Corey0531/Special_Reports_2024/機電資料/IRF520-MOSFET-Switch-module-circuito.jpg

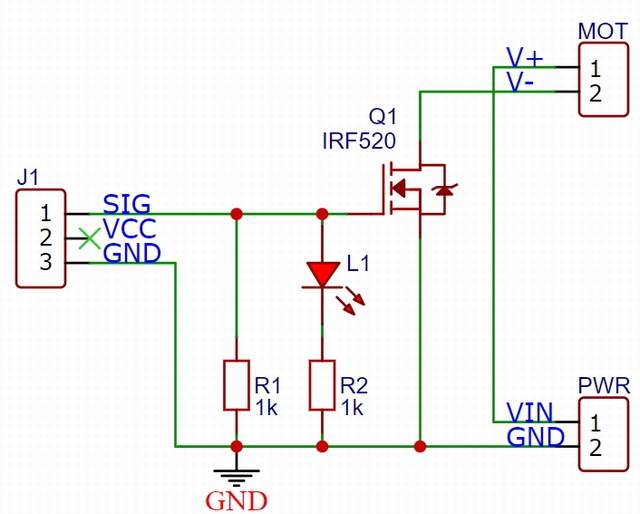
機電資料/IRF520-MOSFET-Switch-module-circuito.jpg
