Corey0531/Special_Reports_2024/機電資料/main_system.png

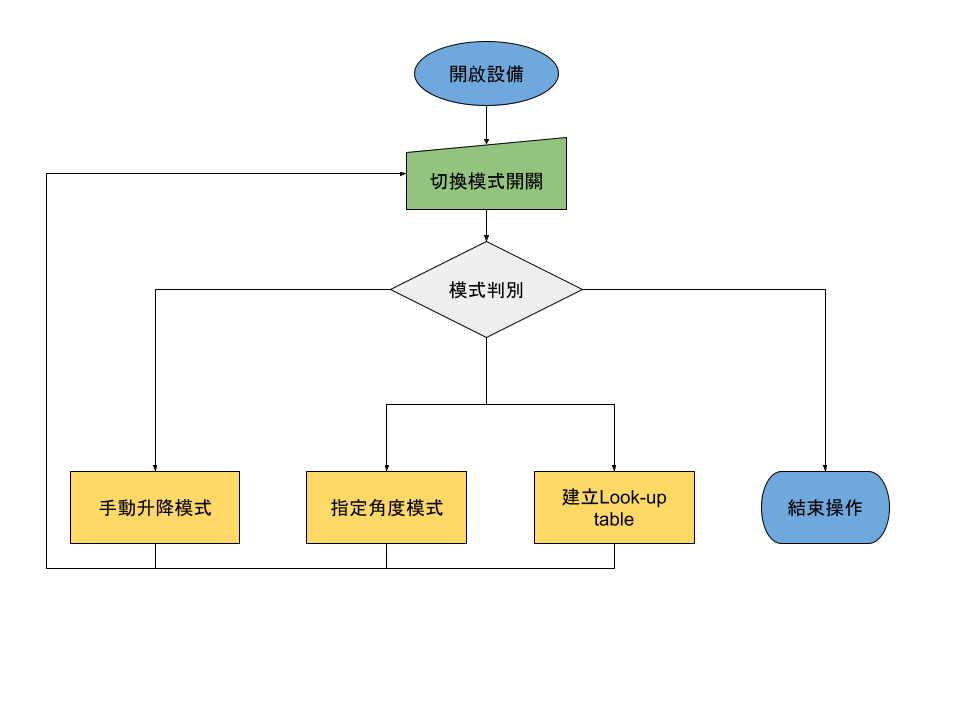
機電資料/main_system.png
