Corey0531/Special_Reports_2024/機電資料/mosfet_arduino.png

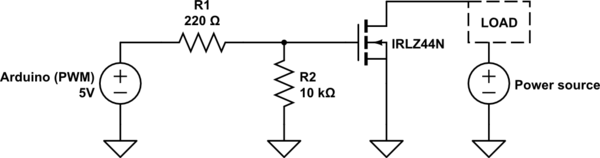
機電資料/mosfet_arduino.png
