Corey0531/Special_Reports_2024/機電資料/學長的電路圖.png

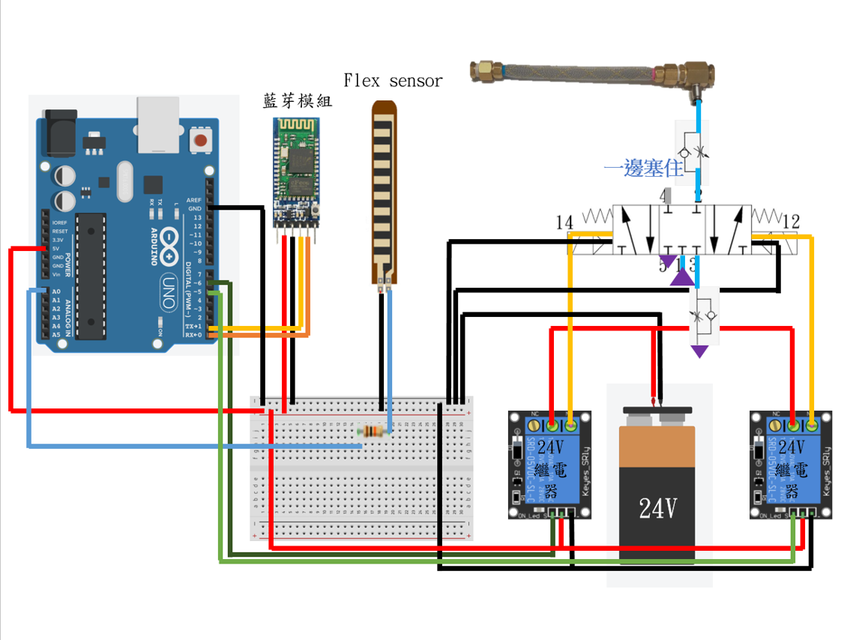
機電資料/學長的電路圖.png
