Corey0531/Special_Reports_2024/外殼creo檔案/編碼器/encoder_main_v4.stl

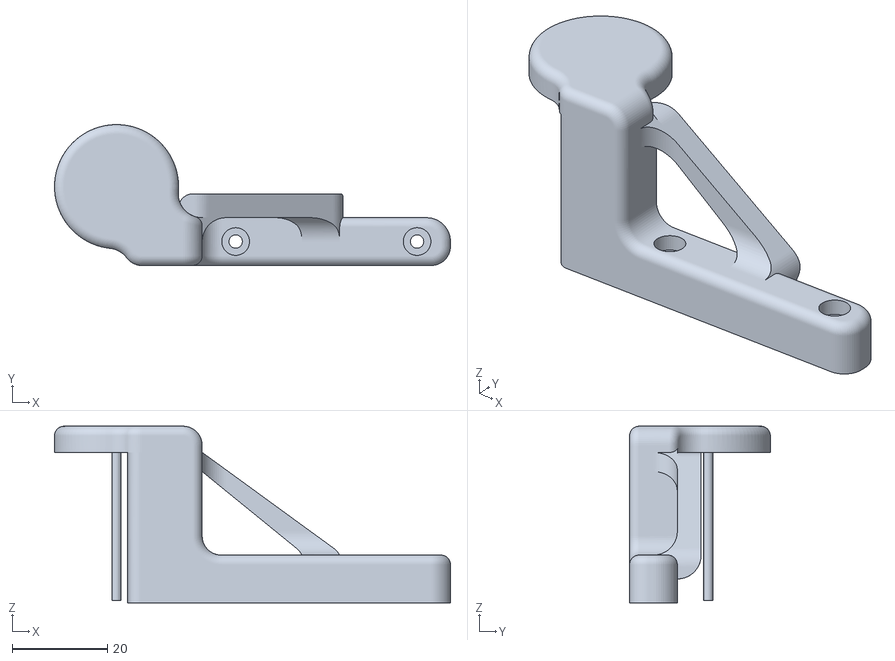
[picture p45: CAD file, 2025-05-28]
外殼creo檔案/編碼器/encoder_main_v4.stl
83.0 x 29.5 x 37.0
