Corey0531/Special_Reports_2024/外殼creo檔案/開關與藍芽/mode_sw_case.stl

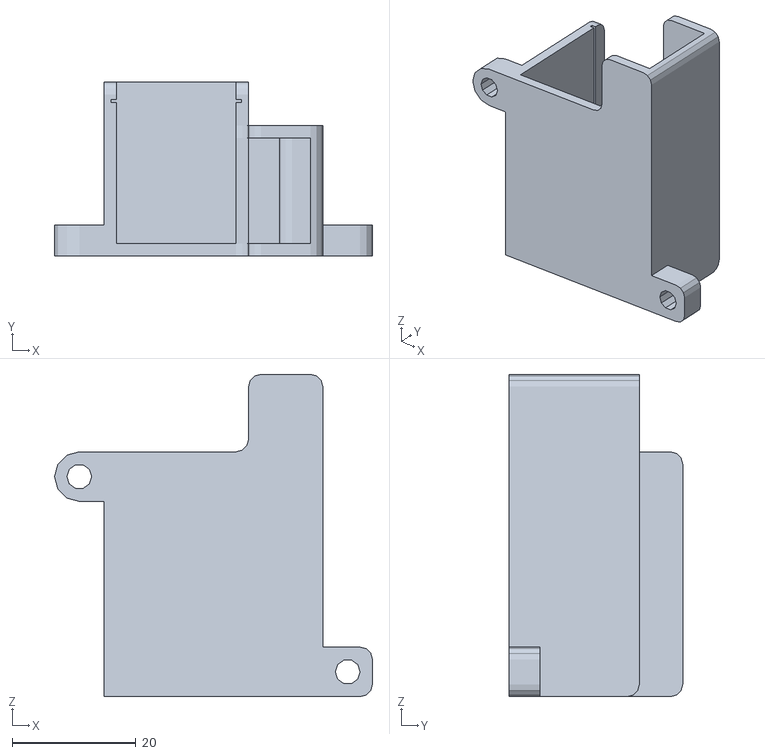
[picture p46: CAD file, 2025-05-28]
外殼creo檔案/開關與藍芽/mode_sw_case.stl
51.3 x 28.0 x 52.0
