Corey0531/Special_Reports_2024/外殼creo檔案/編碼器/HW-040-v1.stl

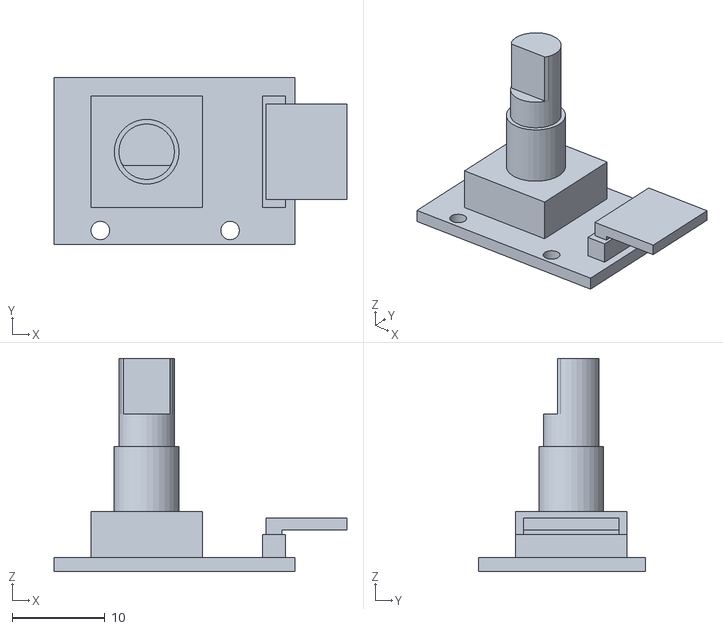
[picture p47: CAD file, 2025-05-28]
外殼creo檔案/編碼器/HW-040-v1.stl
31.6 x 18.0 x 23.0
