Corey0531/Special_Reports_2024/外殼creo檔案/編碼器/encoder_rework_v2.stl

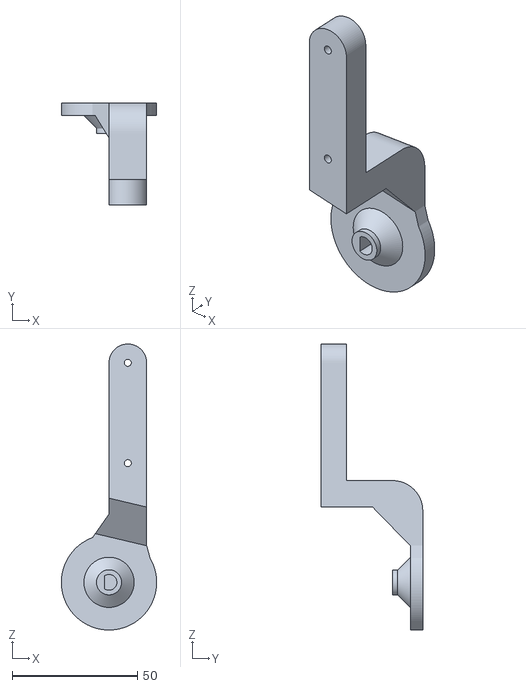
[picture p48: CAD file, 2025-05-28]
外殼creo檔案/編碼器/encoder_rework_v2.stl
38.0 x 40.5 x 114.0
