Corey0531/Special_Reports_2024/外殼creo檔案/編碼器/encoder_shaft.stl

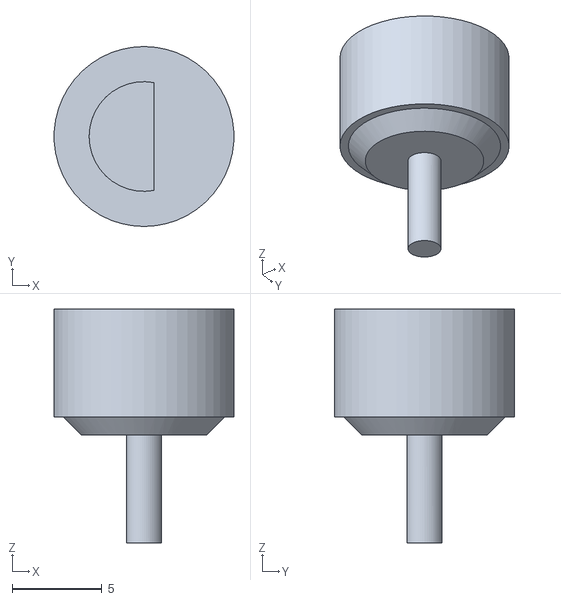
[picture p49: CAD file, 2025-05-28]
外殼creo檔案/編碼器/encoder_shaft.stl
9.98 x 10.0 x 13.0
