Corey0531/Special_Reports_2024/外殼creo檔案/編碼器/encoder_shaft_v2.stl

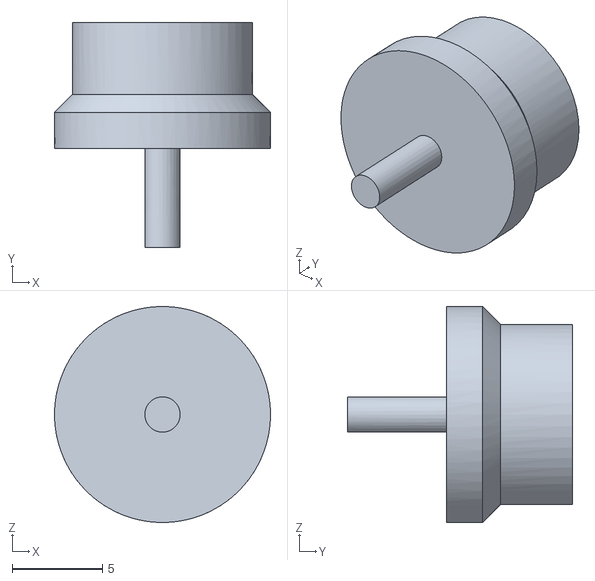
[picture p50: CAD file, 2025-05-28]
外殼creo檔案/編碼器/encoder_shaft_v2.stl
12.0 x 12.5 x 12.0
