Corey0531/Special_Reports_2024/外殼creo檔案/編碼器/encoder_main_v3.stl

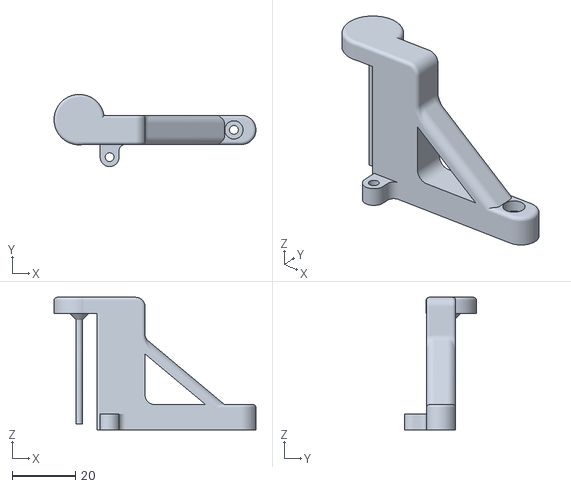
[picture p51: CAD file, 2025-05-28, an earlier design]
外殼creo檔案/編碼器/encoder_main_v3.stl
64.0 x 22.9 x 42.0
