Corey0531/Special_Reports_2024/外殼creo檔案/編碼器/encoder_rework_v1.stl

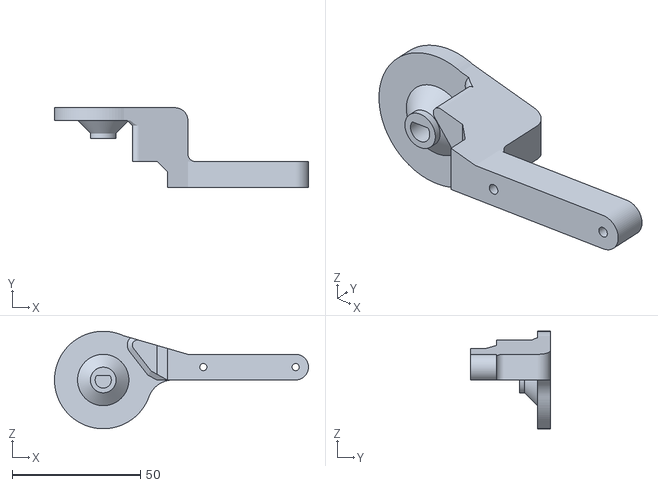
[picture p52: CAD file, 2025-05-28, an earlier design]
外殼creo檔案/編碼器/encoder_rework_v1.stl
99.0 x 31.0 x 38.0
