Corey0531/Special_Reports_2024/arduino程式/encoder/rotary_encoder/rotary_encoder.ino

# define outputA 6
# define outputB 7

int counter = 0 ;
int aState ;
int aLastState   ;

void setup() {
  pinMode (outputA,INPUT);
  pinMode (outputB,INPUT);

  Serial.begin (9600);

  aLastState = digitalRead(outputA);

}

void loop() {
  aState = digitalRead(outputA);
  if (aState != aLastState)
  {
    if (digitalRead(outputB) != aState)
    {
      counter ++ ;
    }
    else
    {
      counter -- ;
    }
    
    Serial.print("Position: ") ;
    Serial.println(counter) ;
  }
  aLastState = aState ;
}
